muhyusufzz/ForcePlate/Flowchart.png

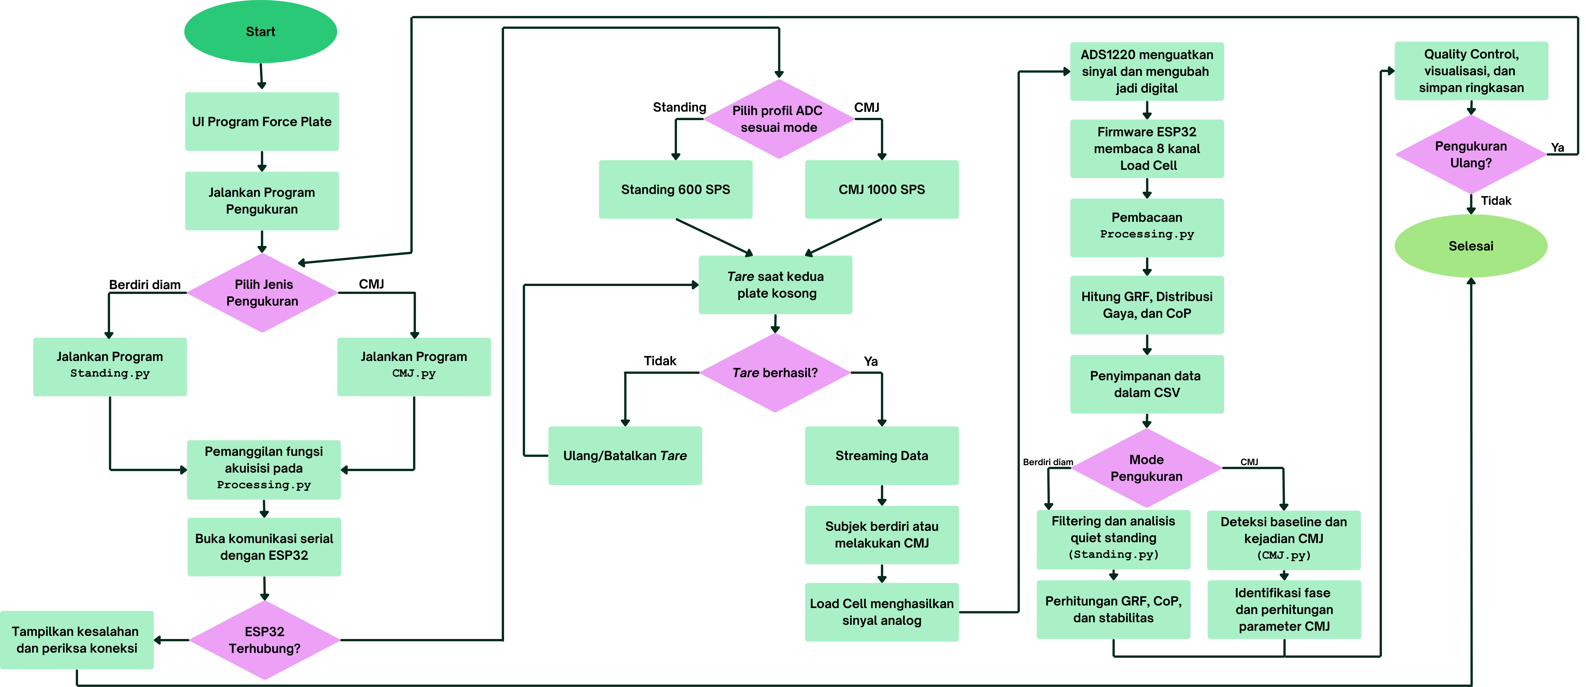
Flowchart.png
