muhyusufzz/ForcePlate/images/Standing_resullt (1).png

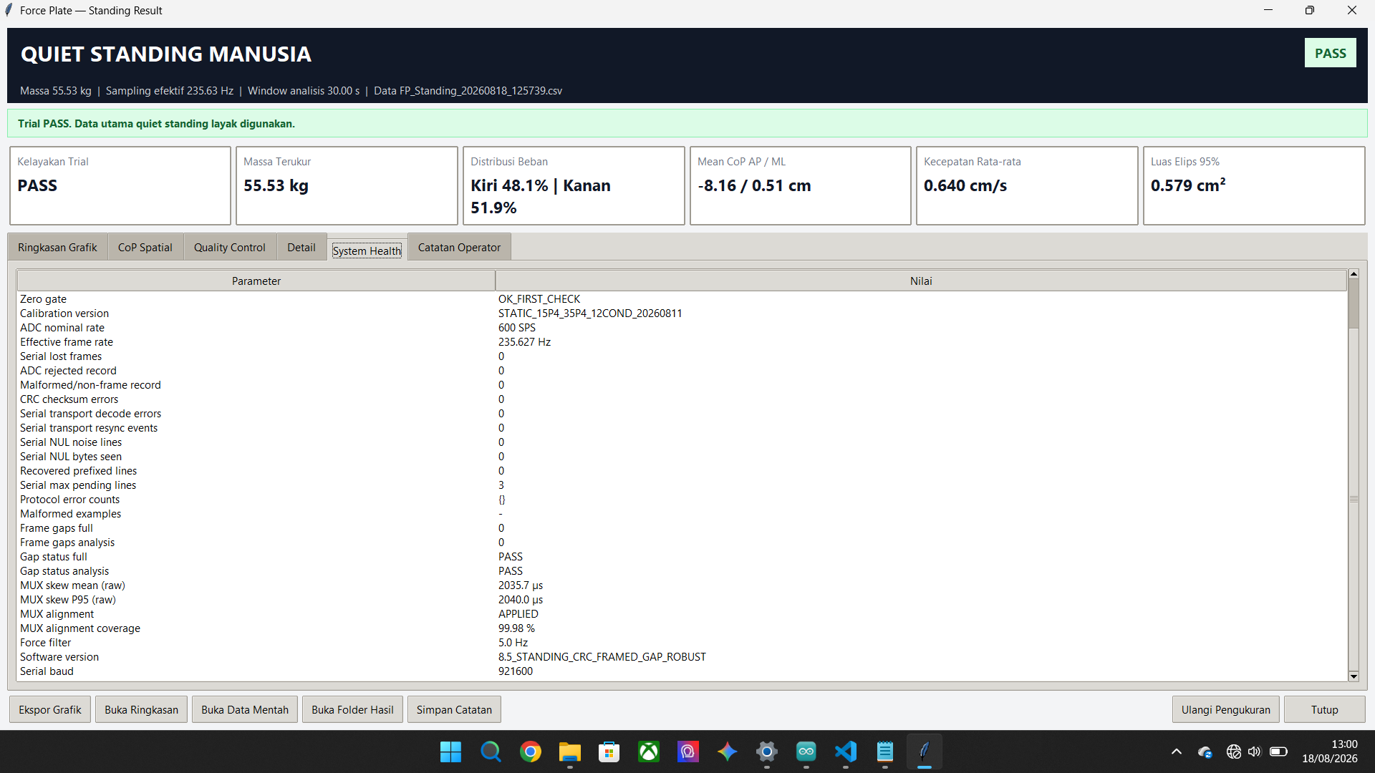
images/Standing_resullt (1).png
