muhyusufzz/ForcePlate/images/Standing_resullt (2).png

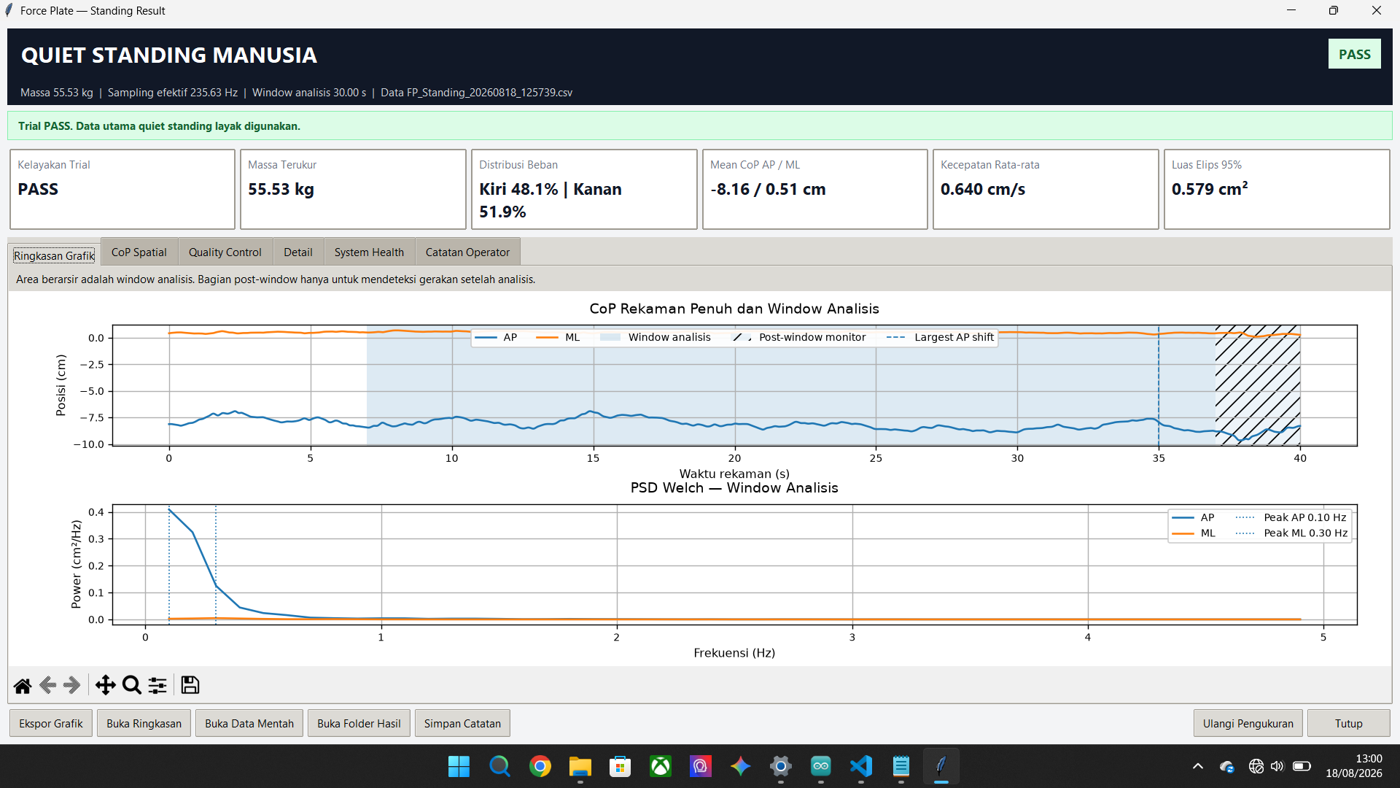
images/Standing_resullt (2).png
