muhyusufzz/ForcePlate/images/Standing_resullt (3).png

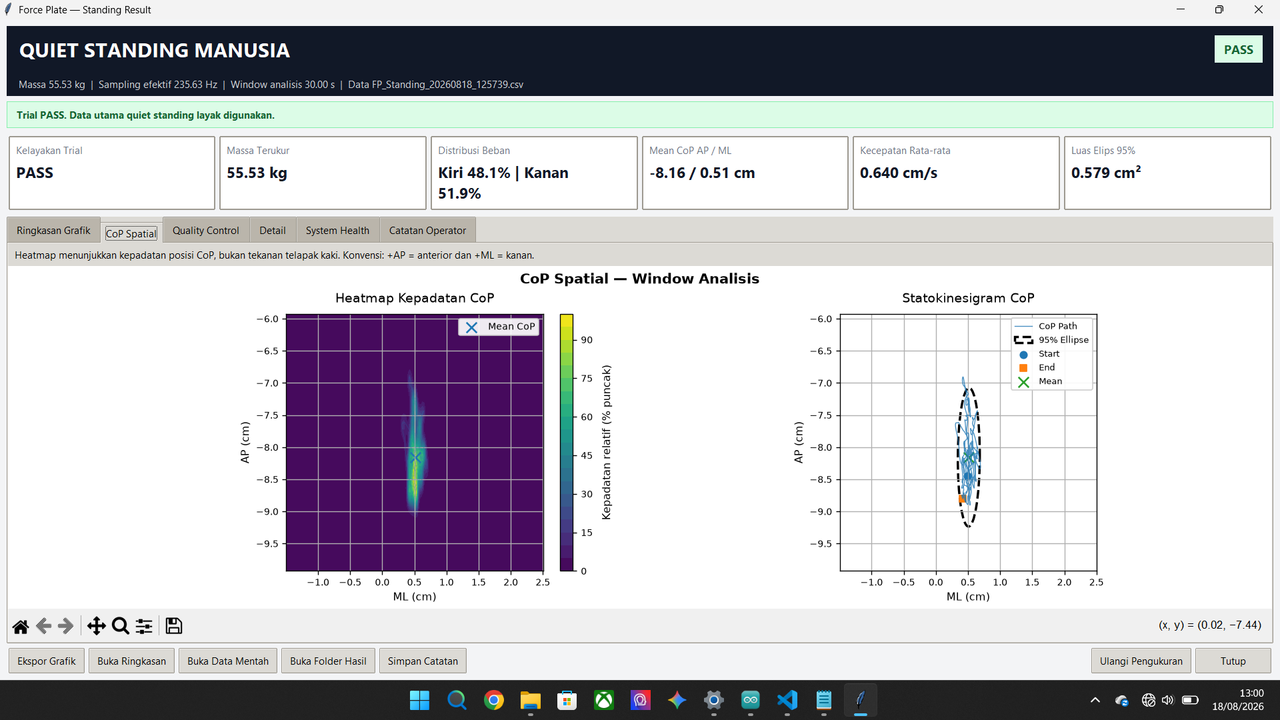
images/Standing_resullt (3).png
