muhyusufzz/ForcePlate/images/Standing_resullt (4).png

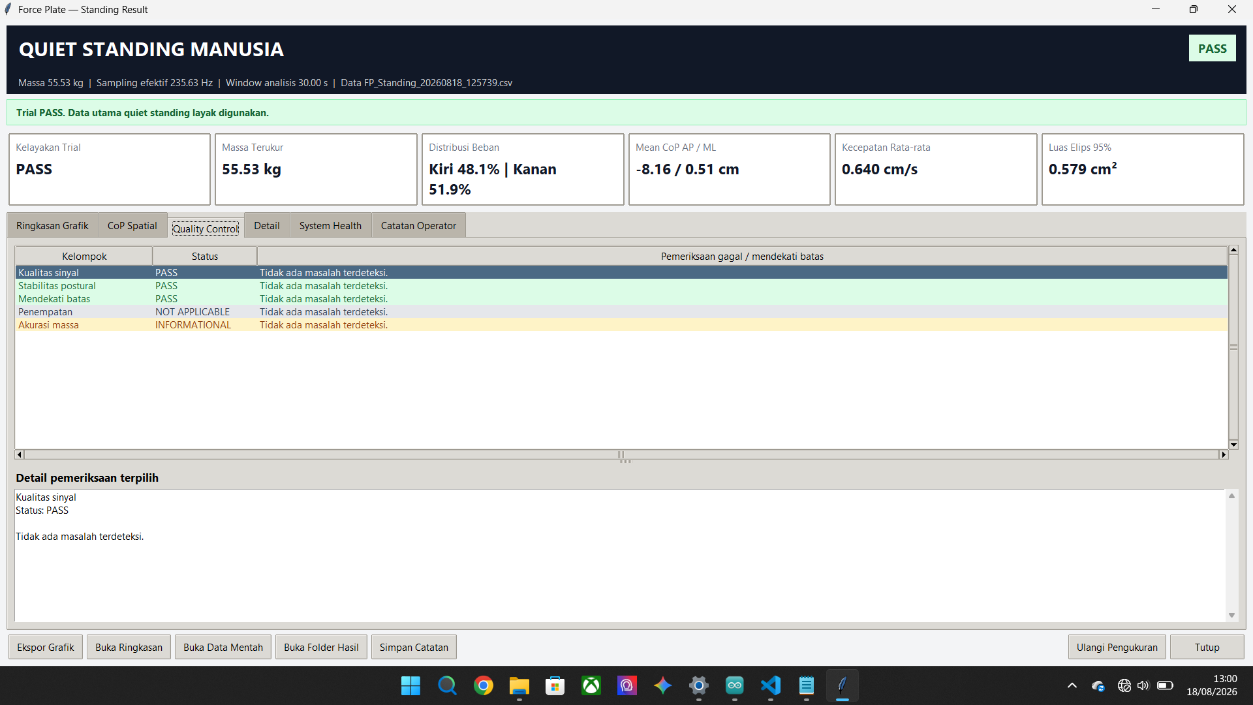
images/Standing_resullt (4).png
