muhyusufzz/ForcePlate/images/Standing_resullt (5).png

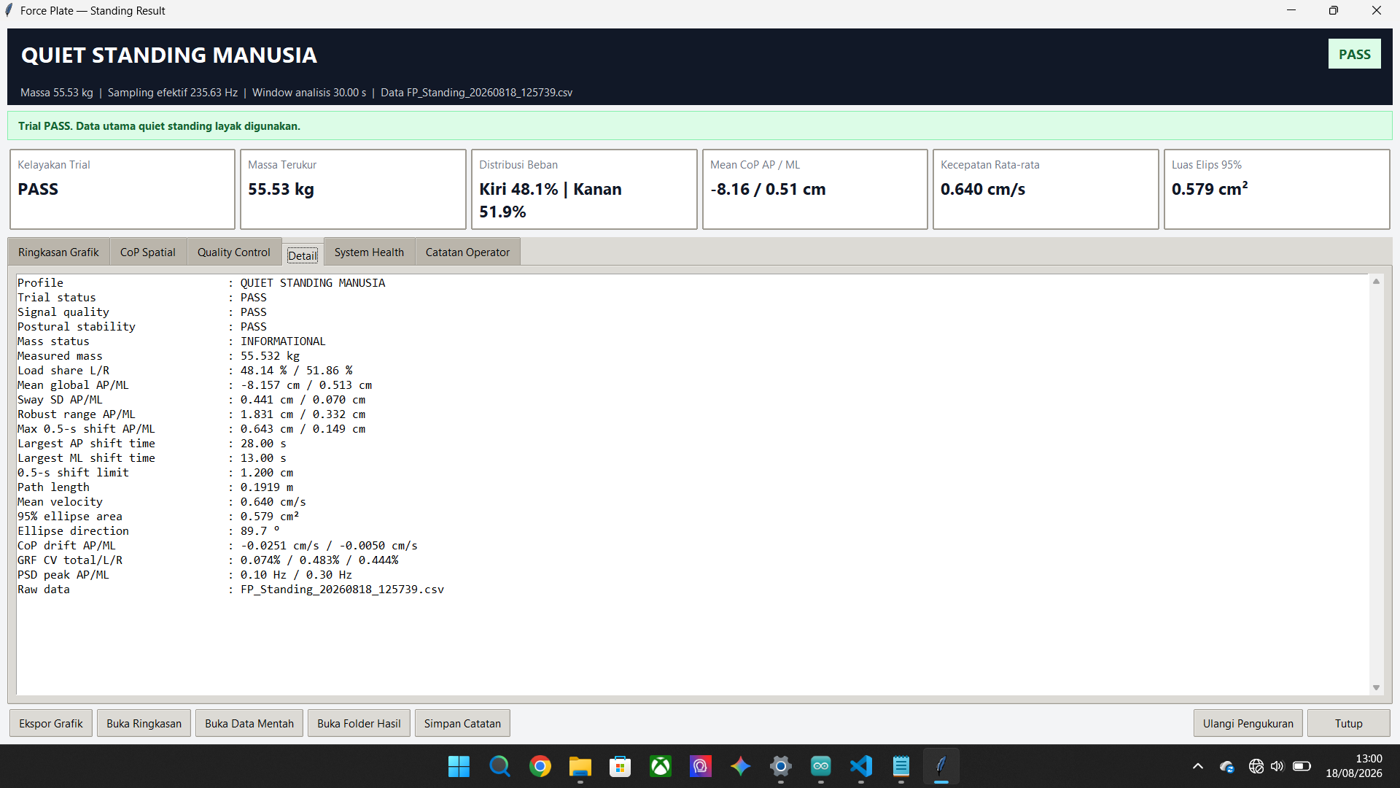
images/Standing_resullt (5).png
