muhyusufzz/ForcePlate/images/Standing_resullt (6).png

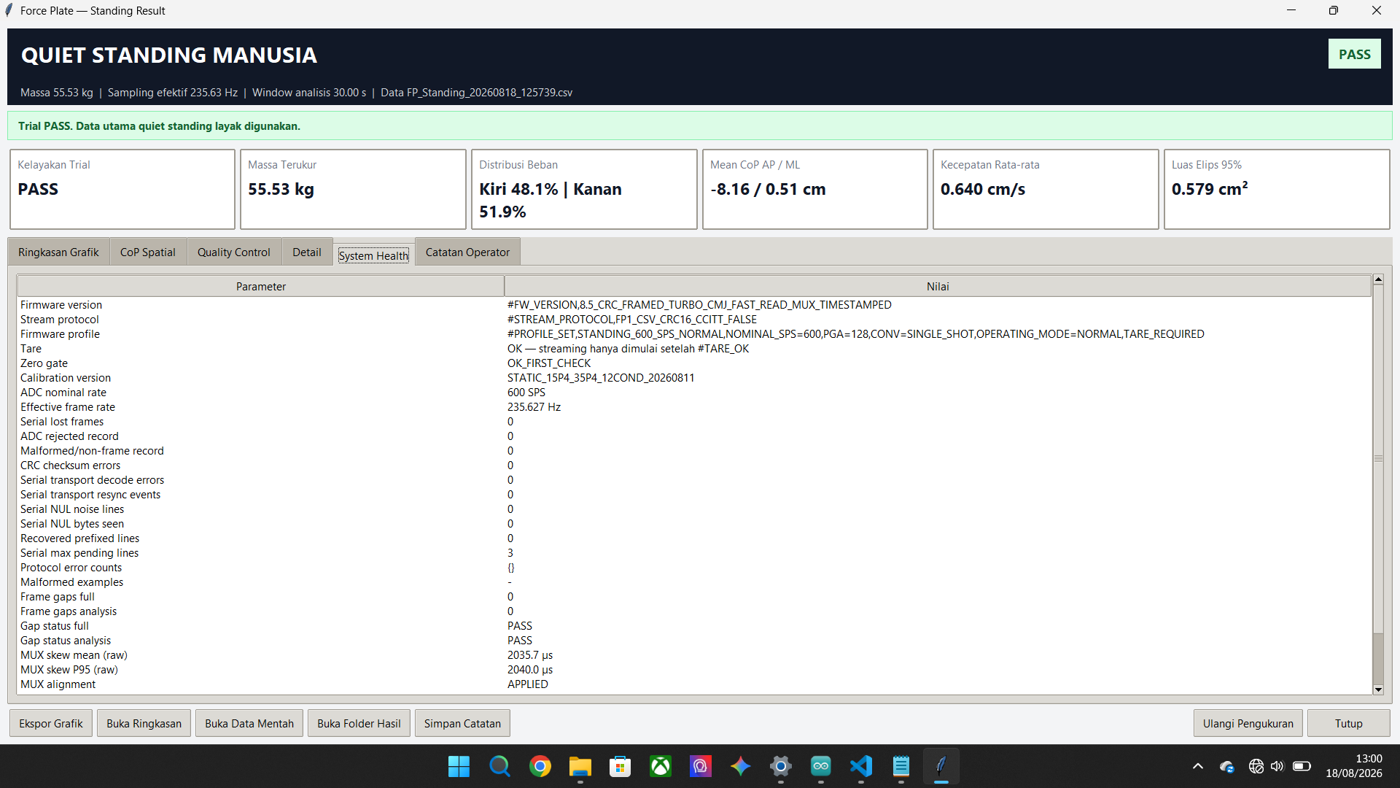
images/Standing_resullt (6).png
