muhyusufzz/ForcePlate/WIRING.docx

Berikut adalah panduan lengkap konfigurasi pengkabelan (wiring) untuk merakit purwarupa dual-plate force plate Anda. Konfigurasi ini disusun persis berdasarkan kode C++ ESP32 dan struktur data Python yang baru saja Anda berikan.

Untuk memudahkan perakitan, sistem ini dibagi menjadi tiga bagian utama: Jalur Digital (SPI), Jalur Sensor (Analog), dan Jalur Daya (Kelistrikan).

1. Jalur Digital (ESP32 ke 4 Modul ADS1220)

Keempat modul ADC berkomunikasi dengan mikrokontroler ESP32 menggunakan protokol SPI. Dalam sistem SPI, ada kabel yang diparalel (digabung ke semua modul) dan ada kabel yang mandiri (khusus untuk tiap modul).

A. Pin SPI Paralel (Digabung ke 4 Modul)

Tarik satu kabel dari pin ESP32 berikut, lalu cabangkan (paralel) ke pin yang sama di Modul 1, Modul 2, Modul 3, dan Modul 4.

- Pin 18 (ESP32) dihubungkan ke SCLK (Semua Modul)
- Pin 19 (ESP32) dihubungkan ke MISO / DOUT (Semua Modul)
- Pin 23 (ESP32) dihubungkan ke MOSI / DIN (Semua Modul)

B. Pin Kontrol Mandiri (Sesuai kode C++)

Kabel-kabel ini tidak boleh digabung. Hubungkan pin Chip Select (CS) dan Data Ready (DRDY) secara langsung dari ESP32 ke masing-masing modul sesuai tabel berikut:

Posisi Modul | Pin CS (ESP32) | Pin DRDY (ESP32) | Keterangan Area
Modul 1 | Pin 5 | Pin 22 | Pelat Kiri (Depan)
Modul 2 | Pin 17 | Pin 16 | Pelat Kiri (Belakang)
Modul 3 | Pin 4 | Pin 21 | Pelat Kanan (Depan)
Modul 4 | Pin 15 | Pin 25 | Pelat Kanan (Belakang)

2. Jalur Sensor Analog (Load Cell ke Modul ADS1220)

Berdasarkan fungsi select_mux_channels() di kode Anda, satu modul ADS1220 bertugas membaca dua buah load cell (menggunakan saluran AIN0-AIN1 dan AIN2-AIN3).

Aturan Warna Kabel Load Cell (Sesuai Standar Anda):

- MERAH (E+) → Hubungkan ke pin AVDD / EXC+ di modul.
- HITAM (E-) → Hubungkan ke pin AVSS / EXC- / GND di modul.
- HIJAU (S+) → Hubungkan ke pin AIN0 (untuk LC Pertama) atau AIN2 (untuk LC Kedua).
- PUTIH (S-) → Hubungkan ke pin AIN1 (untuk LC Pertama) atau AIN3 (untuk LC Kedua).

Pemetaan Load Cell ke 4 Modul:

Pastikan pemasangan fisik kedelapan load cell Anda sesuai dengan pemetaan matriks di bawah ini agar kalkulasi Center of Pressure (CoP) di Python tidak terbalik.

Modul ADS1220 | Channel 1 (AIN0 & AIN1) | Channel 2 (AIN2 & AIN3)
Modul 1 | LC1 Kiri (Kiri Depan) | LC3 Kiri (Kiri Tengah/Kanan Depan)
Modul 2 | LC2 Kiri (Kiri Belakang) | LC4 Kiri (Kiri Tengah/Kanan Belakang)
Modul 3 | LC1 Kanan (Kanan Depan) | LC3 Kanan (Kanan Tengah/Kiri Depan)
Modul 4 | LC2 Kanan (Kanan Belakang) | LC4 Kanan (Kanan Tengah/Kiri Belakang)

(Kabel Merah dan Hitam dari kedua Load Cell pada modul yang sama dapat diparalel ke pin eksitasi yang sama di modul tersebut).

3. Jalur Daya dan Kestabilan Sinyal (Krusial)

Karena kode Anda kini membaca 4 ADC secara serentak (Start_Conv() dipanggil bersamaan), tarikan arus sesaat akan sangat tinggi. Jika daya tidak stabil, Anda akan kembali melihat anomali atau glitch pada grafik Python Anda.

- VCC / VDD (Semua Modul): Hubungkan ke pin 3.3V pada ESP32. (Sangat dilarang menggunakan 5V karena dapat merusak pin SPI ESP32).
- GND (Semua Modul): Hubungkan ke pin GND pada ESP32.
- Kapasitor Decoupling: Wajib memasang kapasitor keramik 100nF (0.1uF) pada setiap modul ADS1220. Solder kapasitor ini menyilang secara paralel sedekat mungkin antara pin VCC dan GND di papan fisik modul ADS1220 untuk meredam noise sirkuit.

Kabel Merah tiap 2 lc ke Avdd 1modul ads

Kabel hitam tiap 2 lc ke agnd 1modul ads
