muhyusufzz/ForcePlate/Wiring (2).png

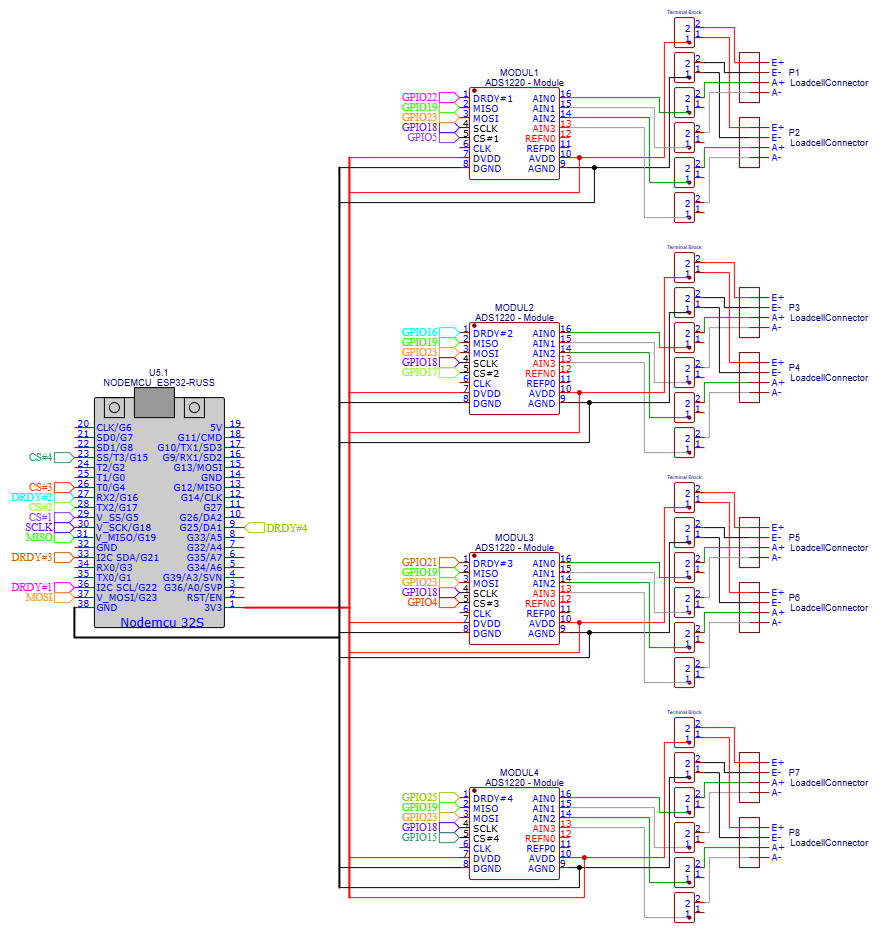
Wiring (2).png
