muhyusufzz/ForcePlate/images/CMJ_result (1).png

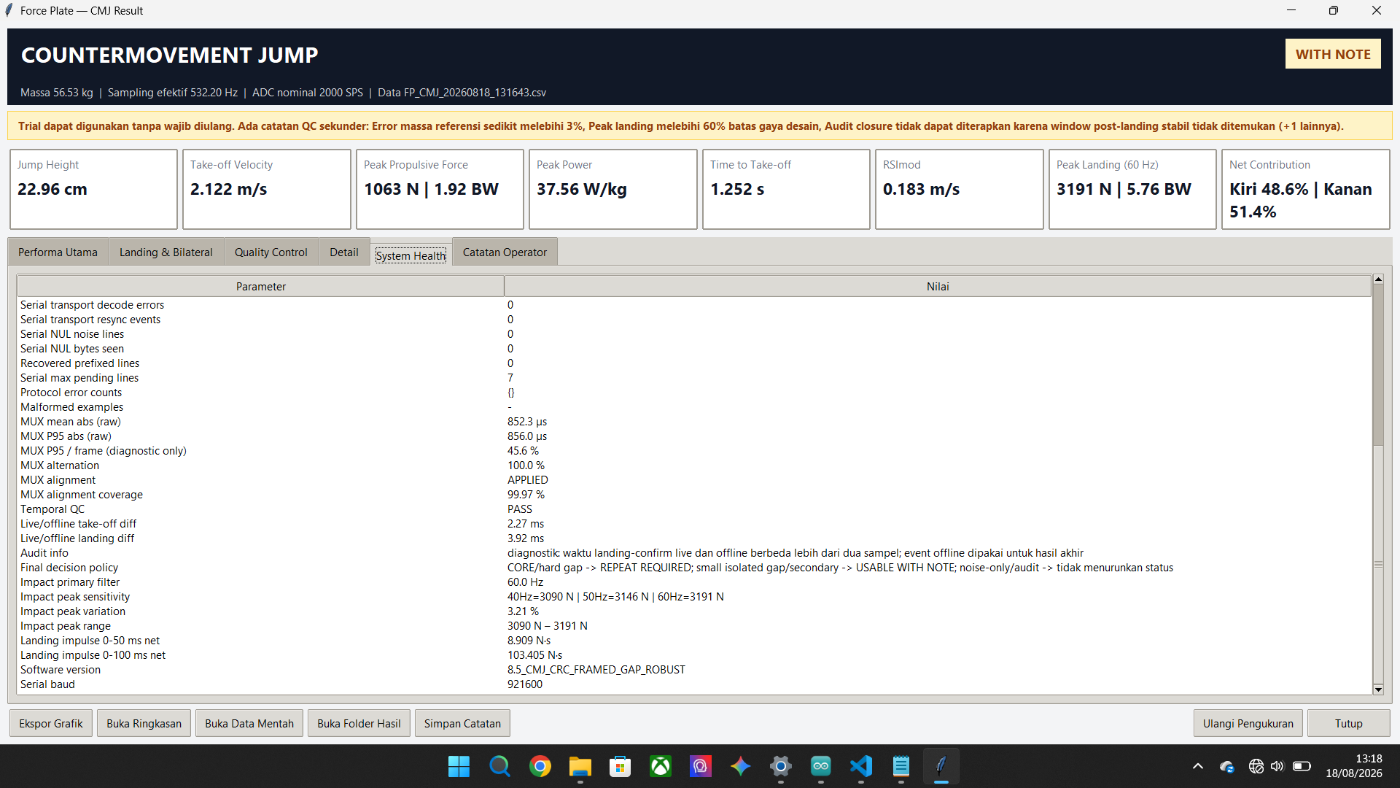
images/CMJ_result (1).png
