muhyusufzz/ForcePlate/images/CMJ_result (2).png

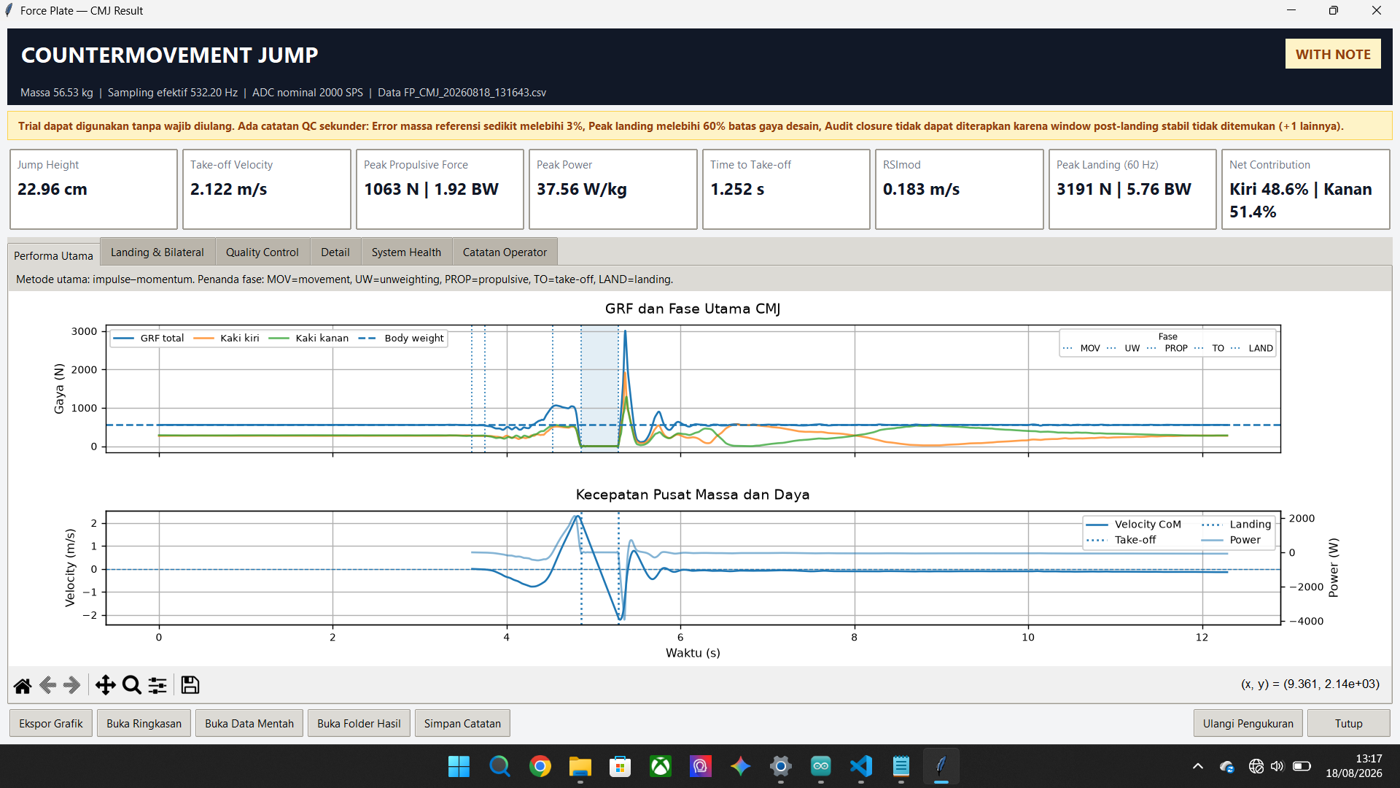
images/CMJ_result (2).png
