muhyusufzz/ForcePlate/images/CMJ_result (3).png

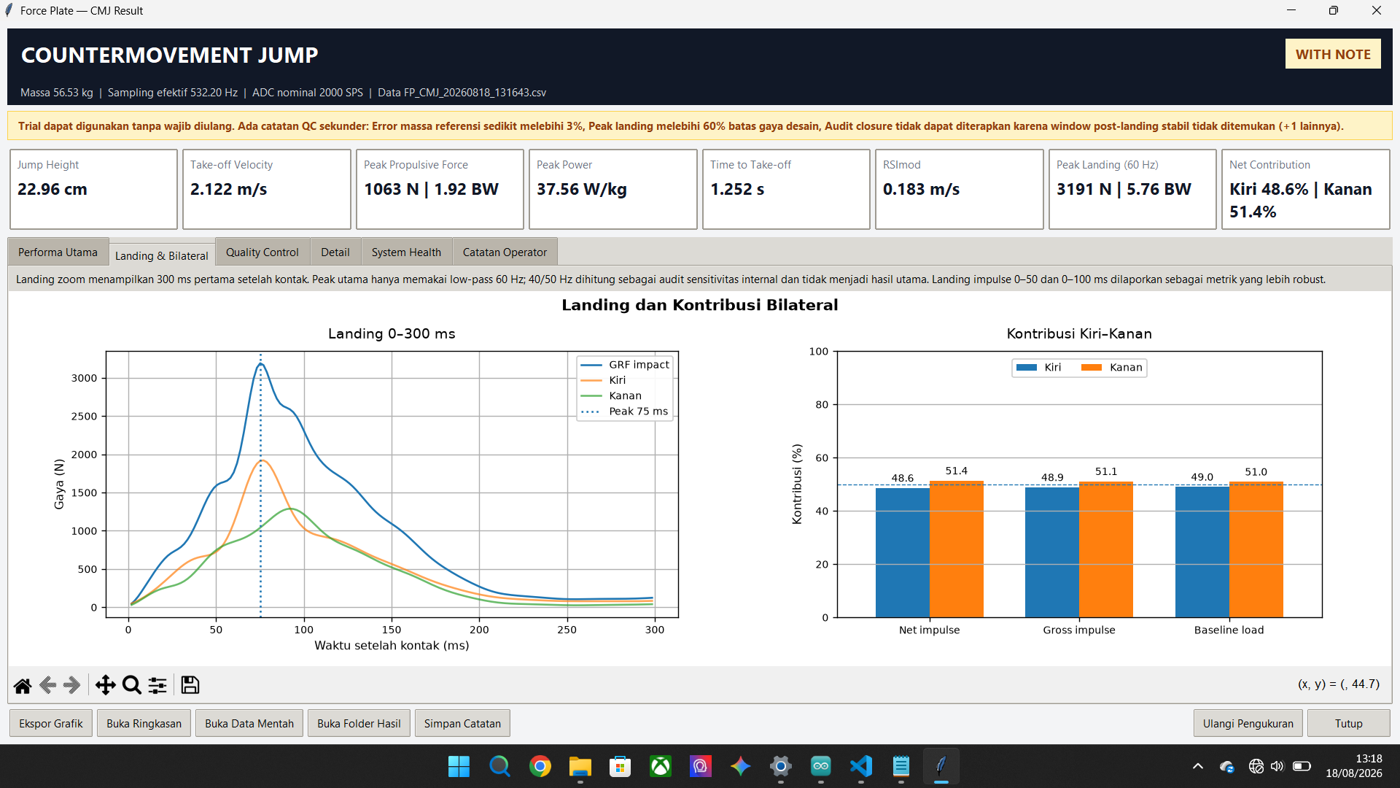
images/CMJ_result (3).png
