muhyusufzz/ForcePlate/images/CMJ_result (4).png

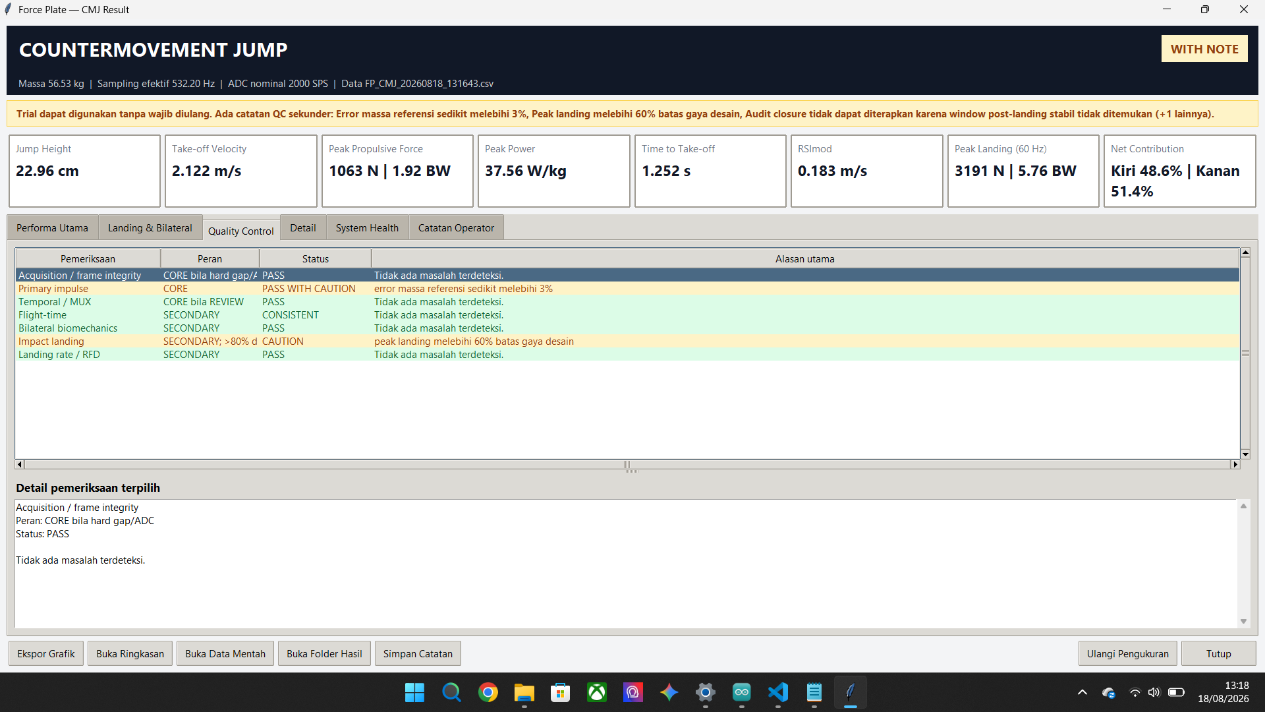
images/CMJ_result (4).png
