muhyusufzz/ForcePlate/images/CMJ_result (5).png

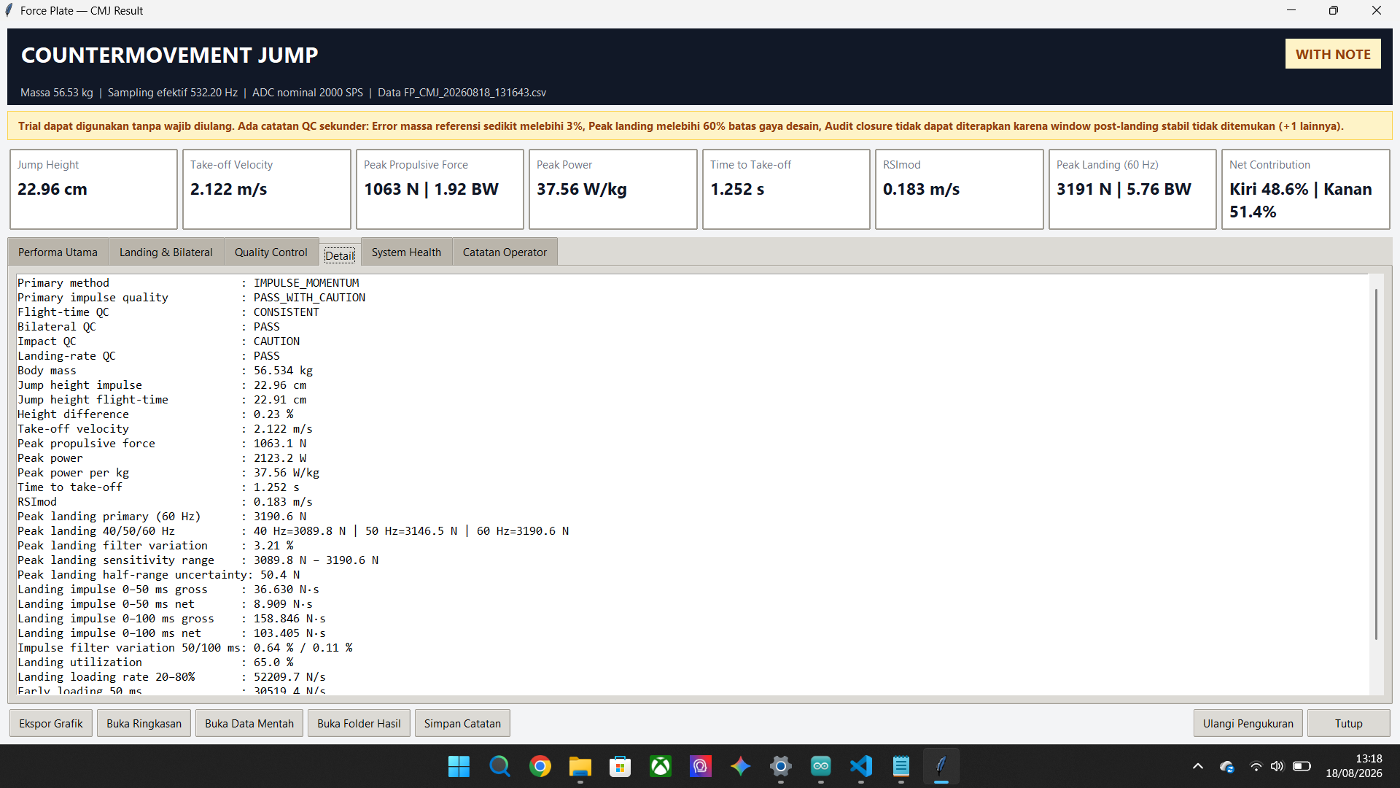
images/CMJ_result (5).png
