muhyusufzz/ForcePlate/images/CMJ_result (6).png

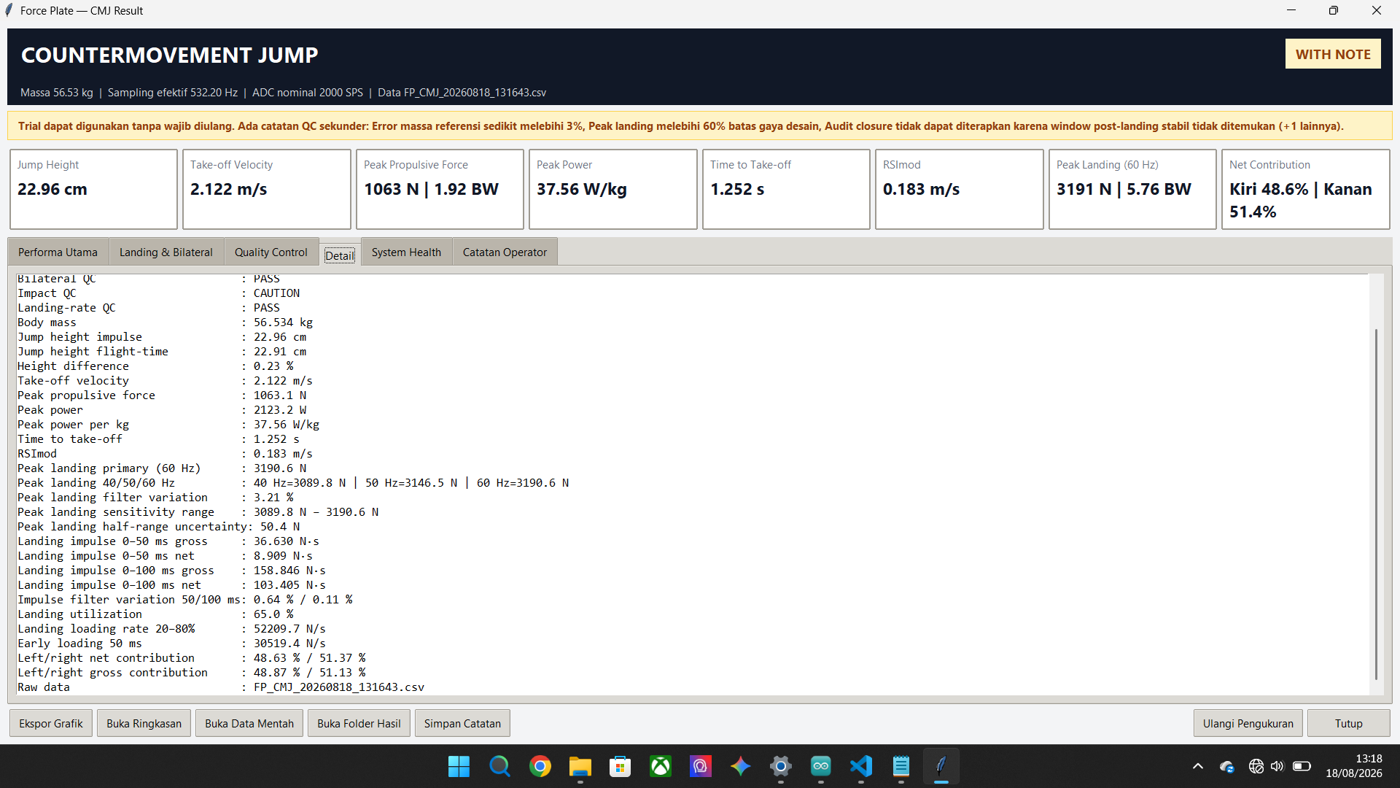
images/CMJ_result (6).png
