muhyusufzz/ForcePlate/images/CMJ_result (7).png

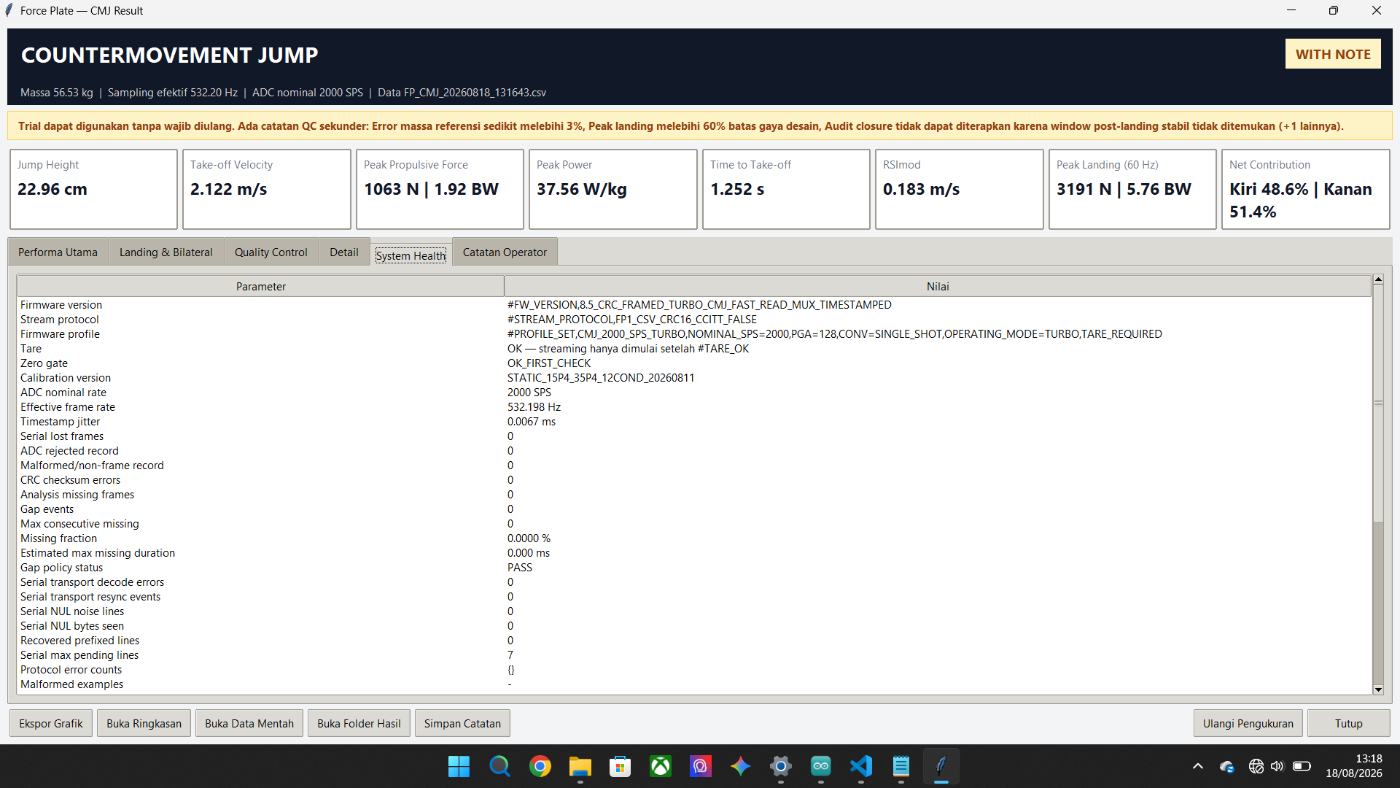
images/CMJ_result (7).png
